ZakKemble/DoorEntryIoT/README.md

IoT and a Door Entry System
===========================

Adding IoT to an old apartment entry system.

https://blog.zakkemble.net/iot-and-a-door-entry-system/

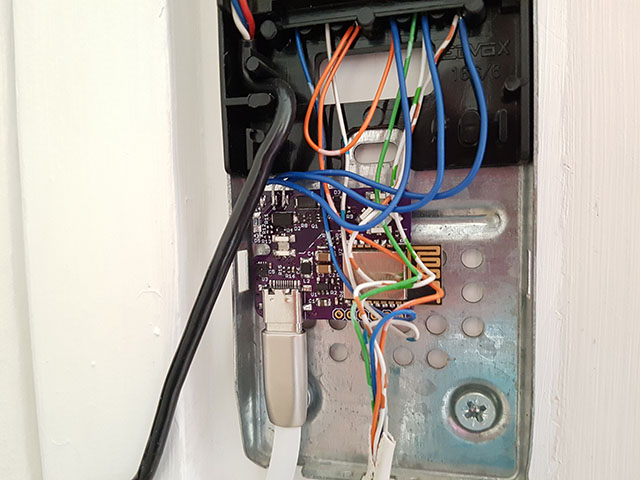
[picture p1: images/doorentry.jpg]
Door Entry pic


---

Zak Kemble

contact@zakkemble.net
