ZakKemble/DoorEntryIoT/hardware/doorEntryIoT.pdf

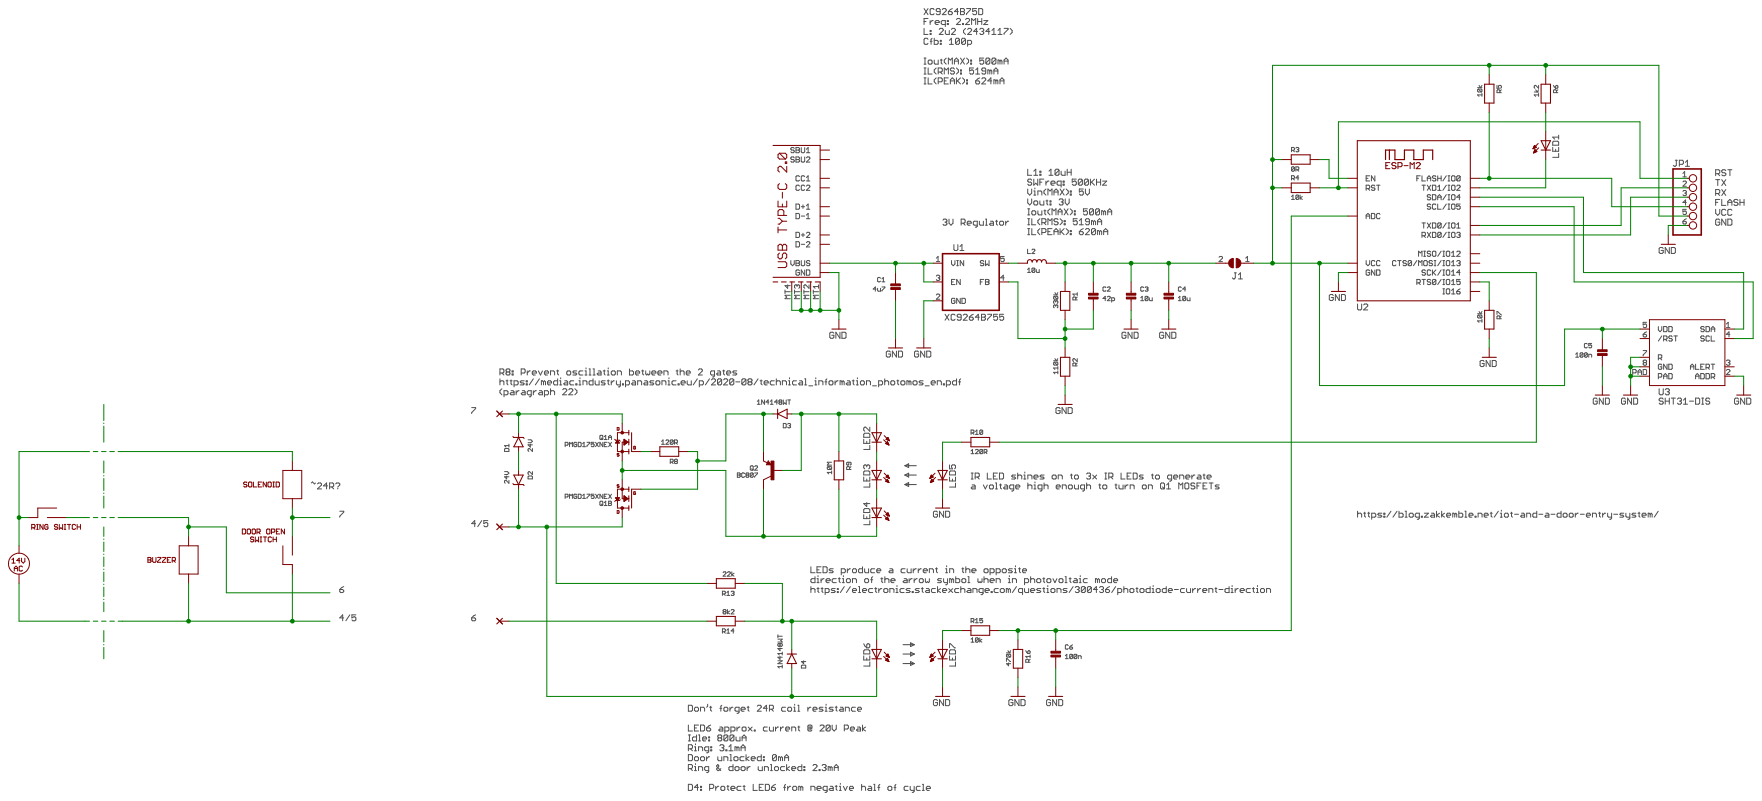
[picture p2: page 1]
