ZakKemble/DoorEntryIoT/hardware/doorEntryIoT.brd

## EAGLE design hardware/doorEntryIoT.brd (2022-02-04)

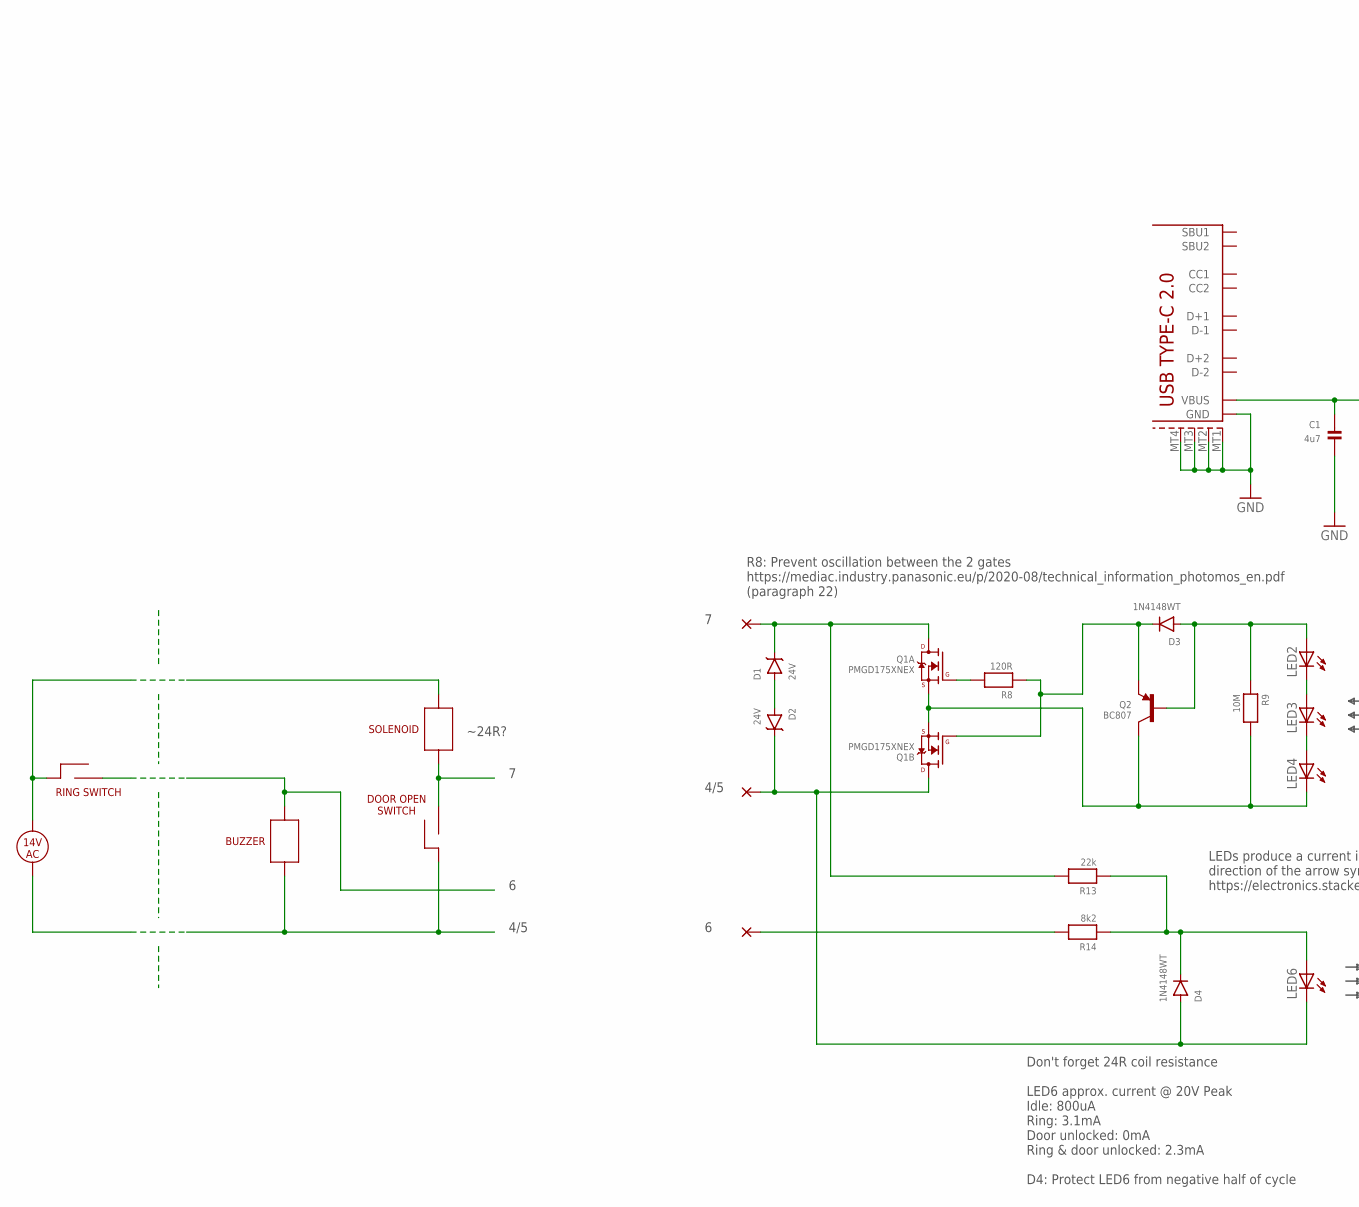
[picture p3: schematic doorEntryIoT.sch, part in row 1, column 1]

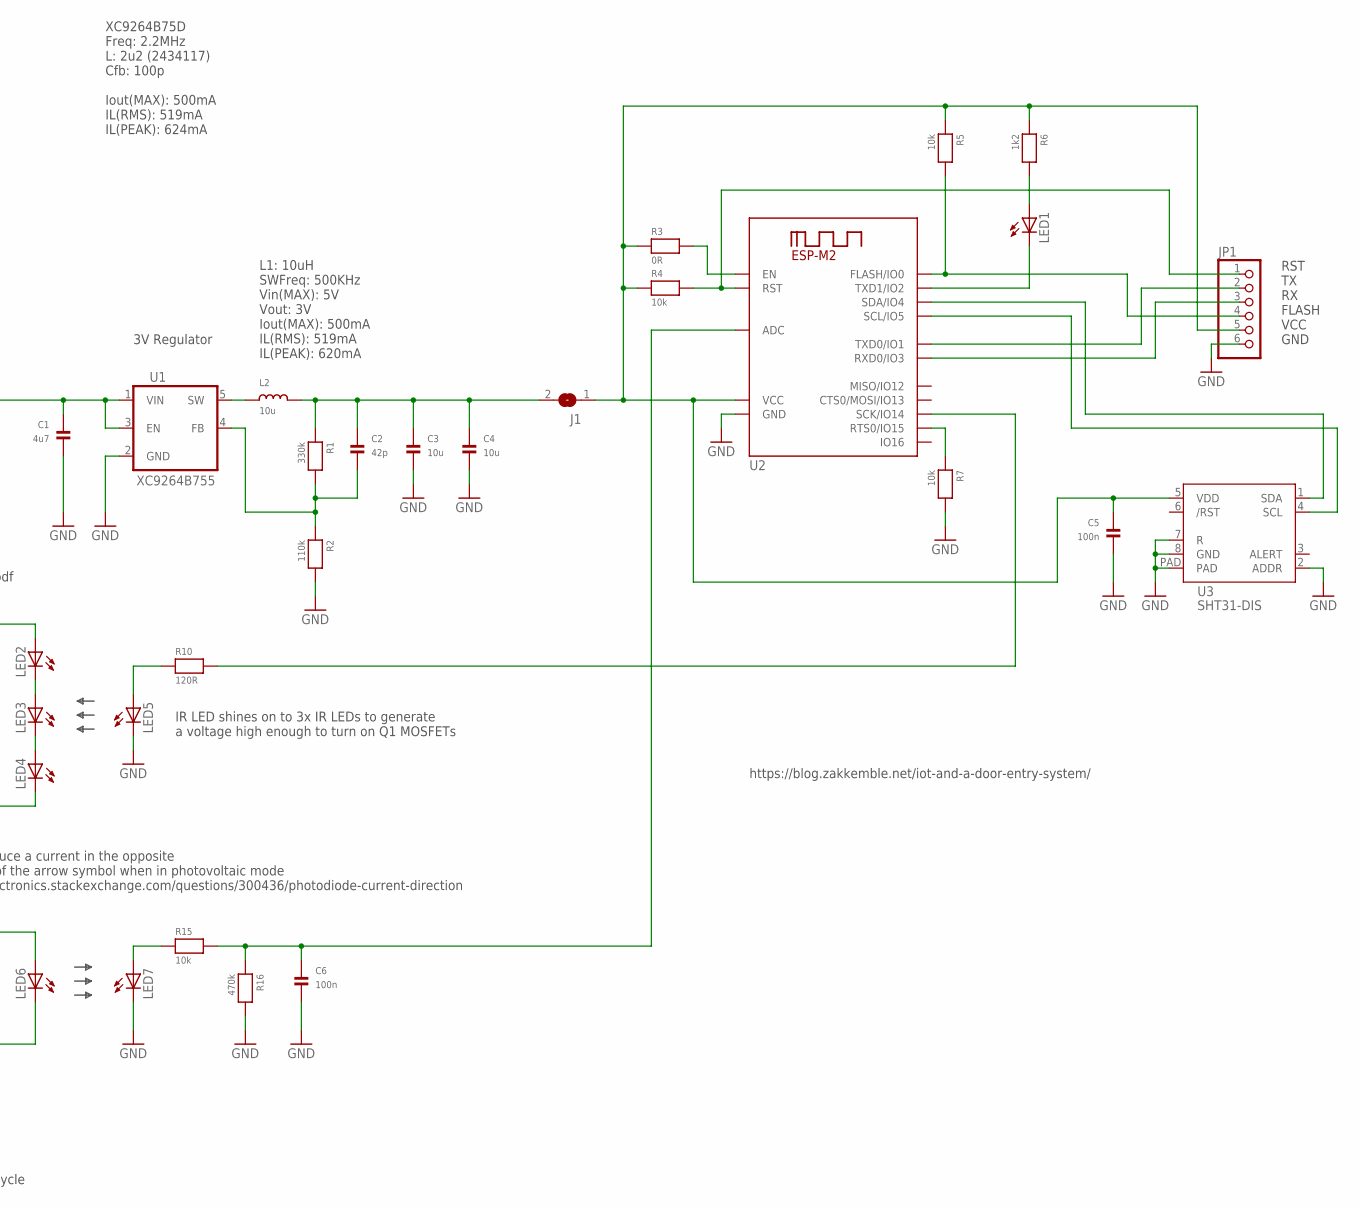
[picture p4: schematic doorEntryIoT.sch, part in row 1, column 2]

Parts:
C1: 4u7; 0805_NO_OUTLINE
C2: 42p; 0402_XSMALL
C3, C4: 10u; 1206; FARNELL 9227881,1828814
C5, C6: 100n; 0402_XSMALL
D1, D2: 24V; SMA; FARNELL 1431151
D3, D4: 1N4148WT; SOD-523_SM
J1: JUMPERSMALL; JUMPER_SMALL
JP1: PINHD-1X6; 1X06
L2: 10u; 1210K; FARNELL 1463485
LED1: LED0402_XSMALL; 0402_DIODE_XSMALL
LED2, LED3, LED4, LED5, LED6, LED7: LEDSIDEVIEW; LED_SIDEVIEW; FARNELL 2426200
PAD1, PAD2, PAD3: PADSMD-1.27X2; PAD-SMD-1.27X2
Q1: PMGD175XNEX; SOT-363; FARNELL 3440057
Q2: BC807; SOT23-R
R1: 330k; 0402_XSMALL
R2: 110k; 0402_XSMALL
R3: 0R; 0402_XSMALL
R4, R5, R7, R15: 10k; 0402_XSMALL
R6: 1k2; 0402_XSMALL
R8, R10: 120R; 0402_XSMALL
R9: 10M; 0402_XSMALL
R13: 22k; 0402_XSMALL
R14: 8k2; 1206; FARNELL 1577394
R16: 470k; 0402_XSMALL
U1: XC9264B755; SOT23-5_SM_PAD; FARNELL 3535735
U2: ESP-M2
U3: SHT31-DIS; DFN_2.5X2.5_8
USB1: USB-TYPE-C-2.0SMD; USB-C-2.0_SMD

Connections:
GND: C1.2, C3.2, C4.2, C5.2, C6.2, JP1.6, LED5.1 (C), LED7.1 (C), R2.2, R7.2, R16.2, U1.2 (GND), U2.8 (GND), U3.2 (ADDR), U3.7 (R), U3.8 (GND), U3.PAD, USB1.A1B2 (GND), USB1.A12B1 (GND), USB1.MT1 (SHEILD1), USB1.MT2 (SHEILD2), USB1.MT3 (SHEILD3), USB1.MT4 (SHEILD4)
unnamed: R3.2, U2.2 (EN)
unnamed: D2.C, D4.A, LED6.1 (C), PAD2.1, Q1.3 (D)
unnamed: R10.2, U2.3 (SCK/IO14)
unnamed: C1.1, U1.1 (VIN), U1.3 (EN), USB1.A4B9 (VBUS), USB1.A9B4 (VBUS)
unnamed: U2.12 (SCL/IO5), U3.4 (SCL)
unnamed: U2.11 (SDA/IO4), U3.1 (SDA)
unnamed: Q1.2 (G), R8.2
unnamed: JP1.1, R4.2, U2.15 (RST)
unnamed: D3.K (C), Q1.5 (G), Q2.2 (E), R8.1
unnamed: C5.1, J1.1, JP1.5, R3.1, R4.1, R5.1, R6.1, U2.7 (VCC), U3.5 (VDD)
unnamed: C2.2, R1.2, R2.1, U1.4 (FB)
unnamed: L2.1, U1.5 (SW)
unnamed: LED5.2 (A), R10.1
unnamed: JP1.4, R5.2, U2.10 (FLASH/IO0)
unnamed: R7.1, U2.6 (RTS0/IO15)
unnamed: LED4.1 (C), Q1.1 (S), Q1.4 (S), Q2.3 (C), R9.2
unnamed: LED2.1 (C), LED3.2 (A)
unnamed: D1.A, D2.A
unnamed: LED1.2 (C), U2.9 (TXD1/IO2)
unnamed: LED3.1 (C), LED4.2 (A)
unnamed: JP1.2, U2.14 (TXD0/IO1)
unnamed: JP1.3, U2.13 (RXD0/IO3)
unnamed: LED1.1 (A), R6.2
unnamed: C6.1, R15.2, R16.1, U2.1 (ADC)
unnamed: D3.A, LED2.2 (A), Q2.1 (B), R9.1
unnamed: LED7.2 (A), R15.1
unnamed: D1.C, PAD3.1, Q1.6 (D), R13.2
unnamed: D4.K (C), LED6.2 (A), R13.1, R14.1
unnamed: PAD1.1, R14.2
unnamed: C2.1, C3.1, C4.1, J1.2, L2.2, R1.1

Notes on the sheet:
RST TX RX FLASH VCC GND
3V Regulator
L1: 10uH SWFreq: 500KHz Vin(MAX): 5V Vout: 3V Iout(MAX): 500mA IL(RMS): 519mA IL(PEAK): 620mA
4/5
IR LED shines on to 3x IR LEDs to generate a voltage high enough to turn on Q1 MOSFETs
Don't forget 24R coil resistance LED6 approx. current @ 20V Peak Idle: 800uA Ring: 3.1mA Door unlocked: 0mA Ring & door unlocked: 2.3mA D4: Protect LED6 from negative half of cycle
~24R?
LEDs produce a current in the opposite direction of the arrow symbol when in photovoltaic mode https://electronics.stackexchange.com/questions/300436/photodiode-current-direction
XC9264B75D Freq: 2.2MHz L: 2u2 (2434117) Cfb: 100p Iout(MAX): 500mA IL(RMS): 519mA IL(PEAK): 624mA
RING SWITCH
BUZZER
SOLENOID
DOOR OPEN SWITCH
14V AC
https://blog.zakkemble.net/iot-and-a-door-entry-system/
R8: Prevent oscillation between the 2 gates https://mediac.industry.panasonic.eu/p/2020-08/technical_information_photomos_en.pdf (paragraph 22)

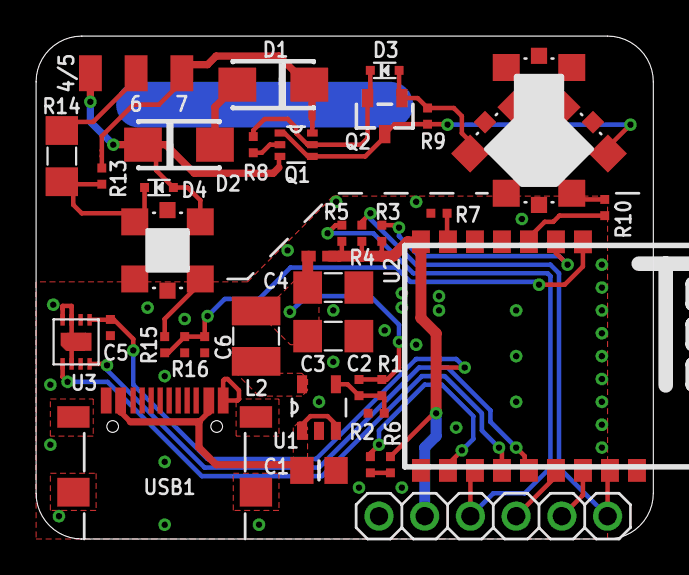
[picture p5: board doorEntryIoT.brd from above]

Board: 2 copper layers, 34.3 x 27.9 mm, 43 parts (0 on the bottom side), 31 nets.
